bit-bots/bit_foot/electronics/README.md

The black board is the current version, the green version should not be used anymore and is only for documentation.

A fully functional BitFoot is composed of a black base board and a esp_connector board
