bit-bots/bit_foot/firmware/README

Use ADS Library available at https://github.com/Molorius/ADS126X
Use Dynamixel2Arduino library 
Use ESP32 board from Arduino board manager
