bit-bots/bit_foot/electronics/BOM_black.csv

ID | Name | Designator | Footprint | Quantity
1 | CONNEC_1X041.5 | P1,P2,P3,P4 | JST ZH 4PIN 1.5MM | 4
2 | TS2937CW-5.0 | U2 | SOT-223 | 1
3 | TS2940CW-3.3 | U3 | SOT-223 | 1
4 | 1K | R2,R1,R4,R3,R6,R5,R8,R7 | 0805 | 8
5 | 4K7 | R15,R11 | 0805 | 2
6 | ??? | R9 | 0805 | 1
7 | 22R | R19,R20 | 0805 | 2
8 | 47R | R10,R12,R13,R14,R16,R17,R18 | 0805 | 7
9 | DXL_TTL | P5 | MOLEX_SPOX_3 | 1
10 | 470nF | C22 | CASE-A_3216 | 1
11 | 1nF | C7,C6,C5,C10,C9,C8,C16,C15,C14,C19,C18,C17 | C0805 | 12
12 | 4.7nF | C11 | C0805 | 1
13 | 1uF | C13,C12,C1,C4 | C0805 | 4
14 | 0.1uF | C2,C3 | C0805 | 2
15 | 100nF | C24 | C0805 | 1
16 | 10uF | C21,C20 | CASE-B_3528 | 2
17 | SP485EEN-L/TR | U5 | SOIC-8_150MIL | 1
18 | 22uF | C23 | CASE-B_3528 | 1
19 | SMBJ9.0CA | D1,D2 | SMB(DO-214AA) | 2
20 | ADS1262 | U1 | TSSOP28 | 1
21 | DXL_RS485 | P6 | MOLEX SPOX | 1
22 | Header-Male-2.54_1x2 | H1 | HDR-2X1/2.54 | 1
