bit-bots/bit_foot/electronics/BOM_esp32_connector_board.csv

ID | Name | Designator | Footprint | Quantity | Manufacturer Part | Manufacturer
1 | SN74LV1T34DBVR | U2 | TSOT-23-5_L2.9-W1.6-P0.95-LS2.8-BL | 1 | SN74LV1T34DCKR | Texas Instruments
2 | ESP32-WROOM-32U | U1 | WIFIM-SMD_38P-L19.2-W18.0-P1.27 | 1 | ESP32-WROOM-32U | Espressif Systems
3 | 100nF | C2,C3 | C0805 | 2
4 | 10uF | C1 | C0805 | 1
6 | 4k7 | R1 | 0805 | 1
