bit-bots/bit_foot/electronics/schematic_black.pdf

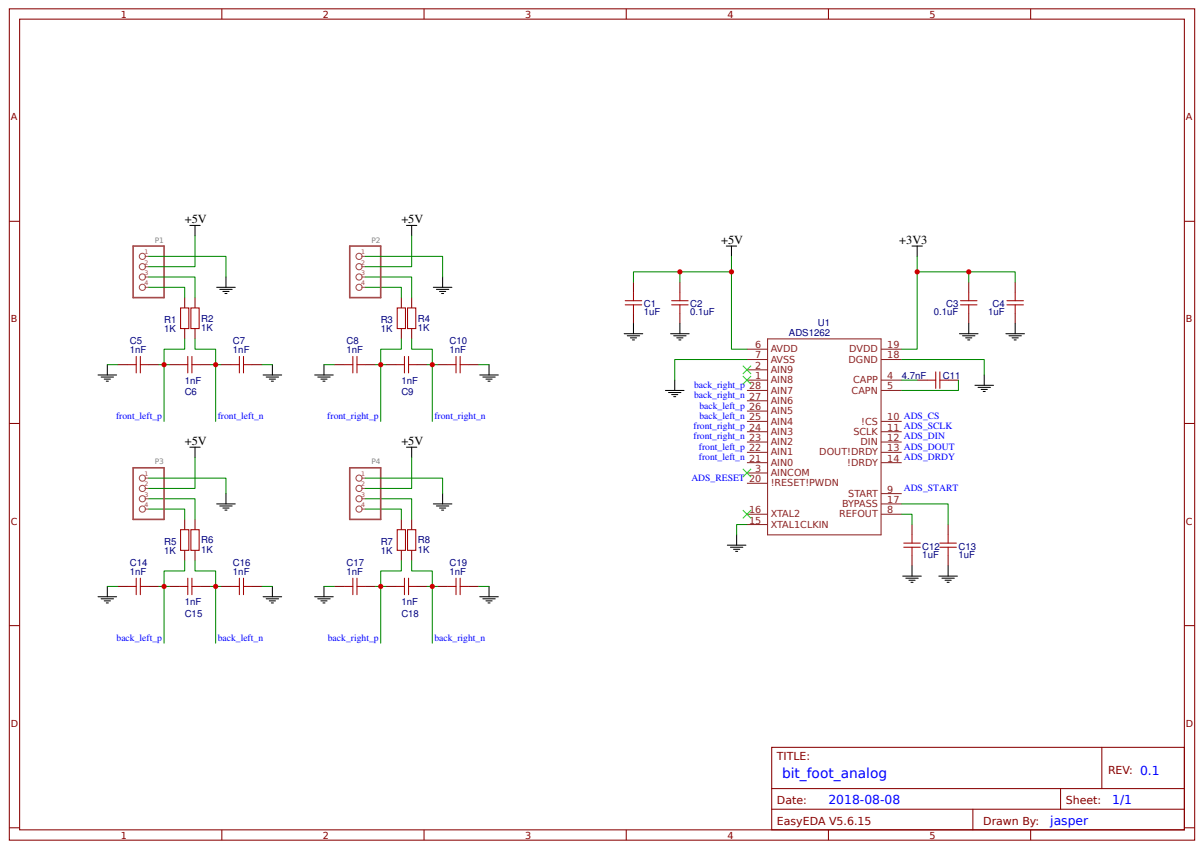
[picture p2: page 1]

V_DXL | 4
V_DXL | +5V

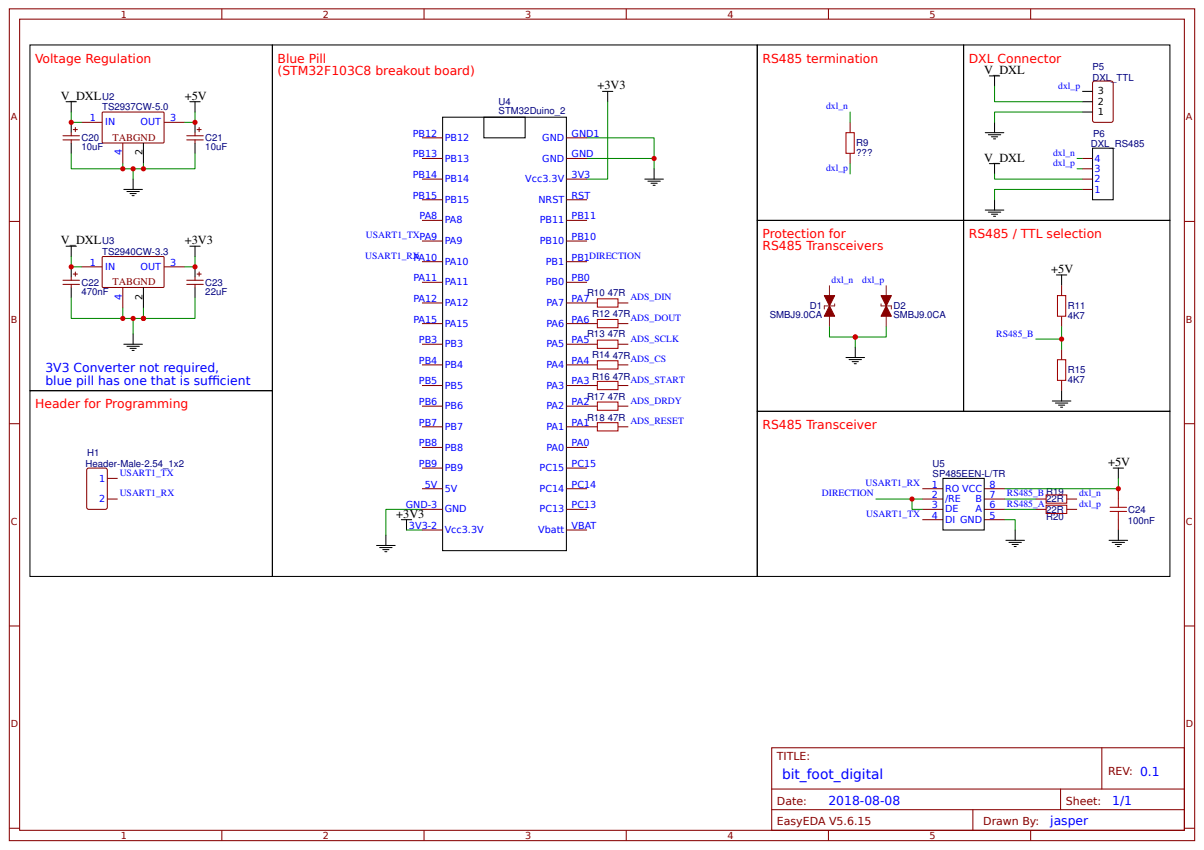
[picture p3: page 2]

3V3 Converter not required,
blue pill has one that is sufficient
Header for Programming
