bit-bots/bit_foot/electronics/schematic_green.pdf

V_DXL | 4
V_DXL | +5V

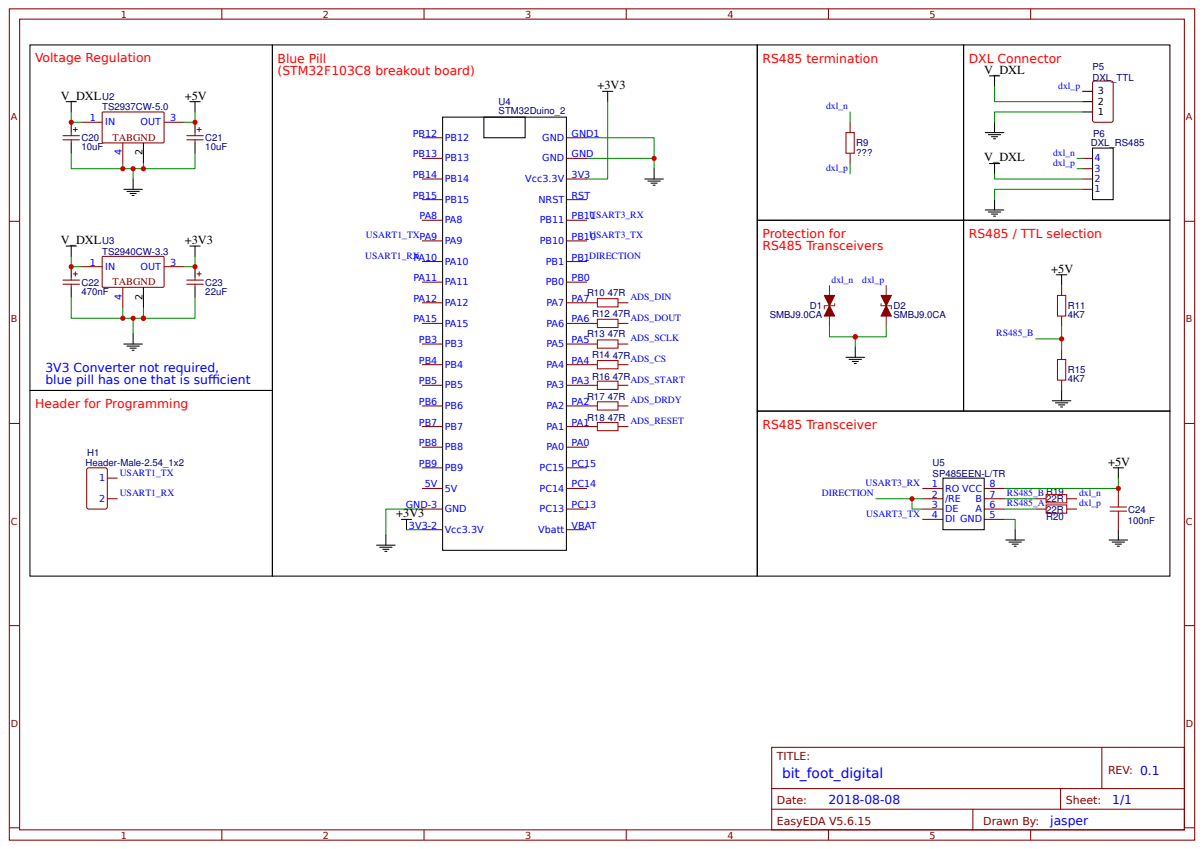
[picture p4: page 2]

3V3 Converter not required,
blue pill has one that is sufficient
Header for Programming
