bit-bots/bit_foot/electronics/board_esp_connector.pdf

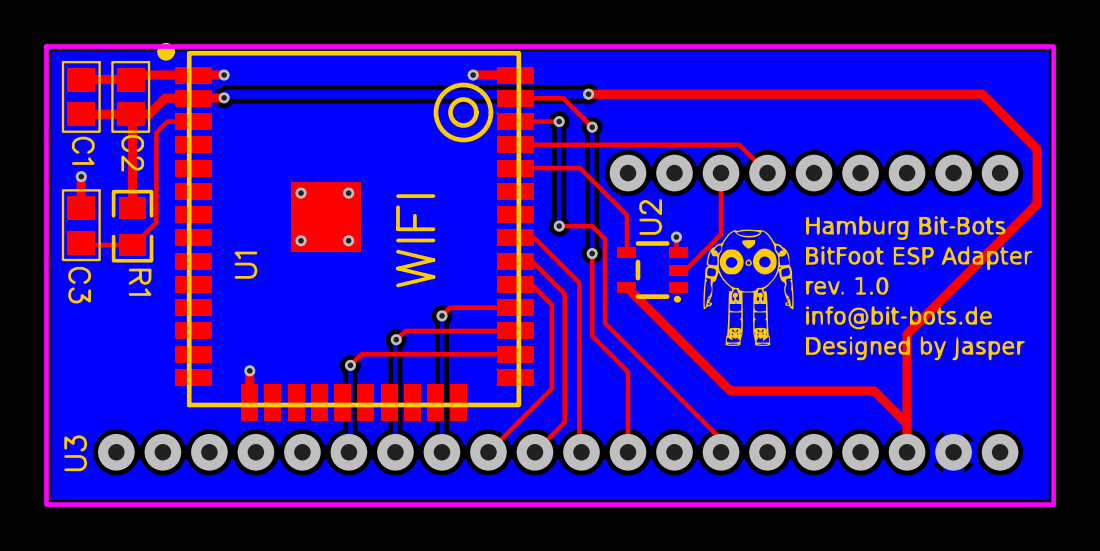
[picture p5: page 1]
