bit-bots/bit_foot/electronics/esp_connector.pdf

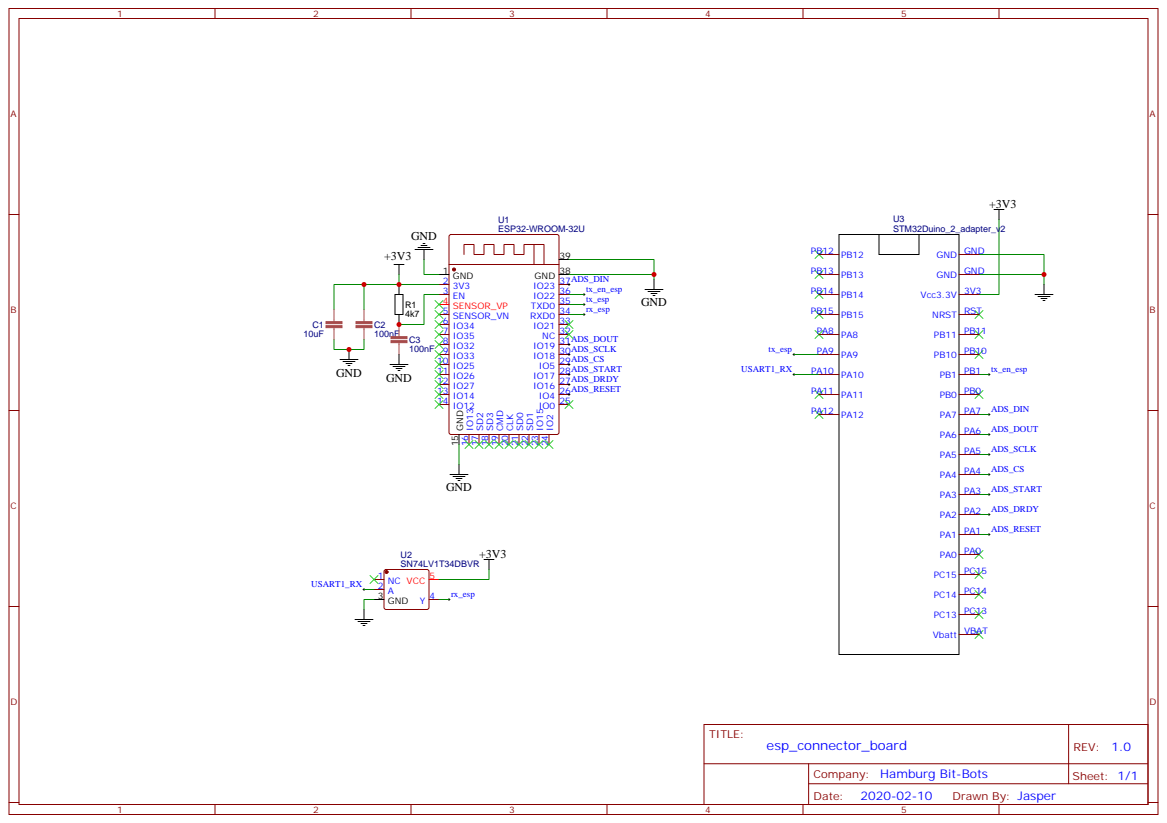
[picture p6: page 1]

Company: Hamburg Bit-Bots
