bit-bots/bit_foot/electronics/board_black.pdf

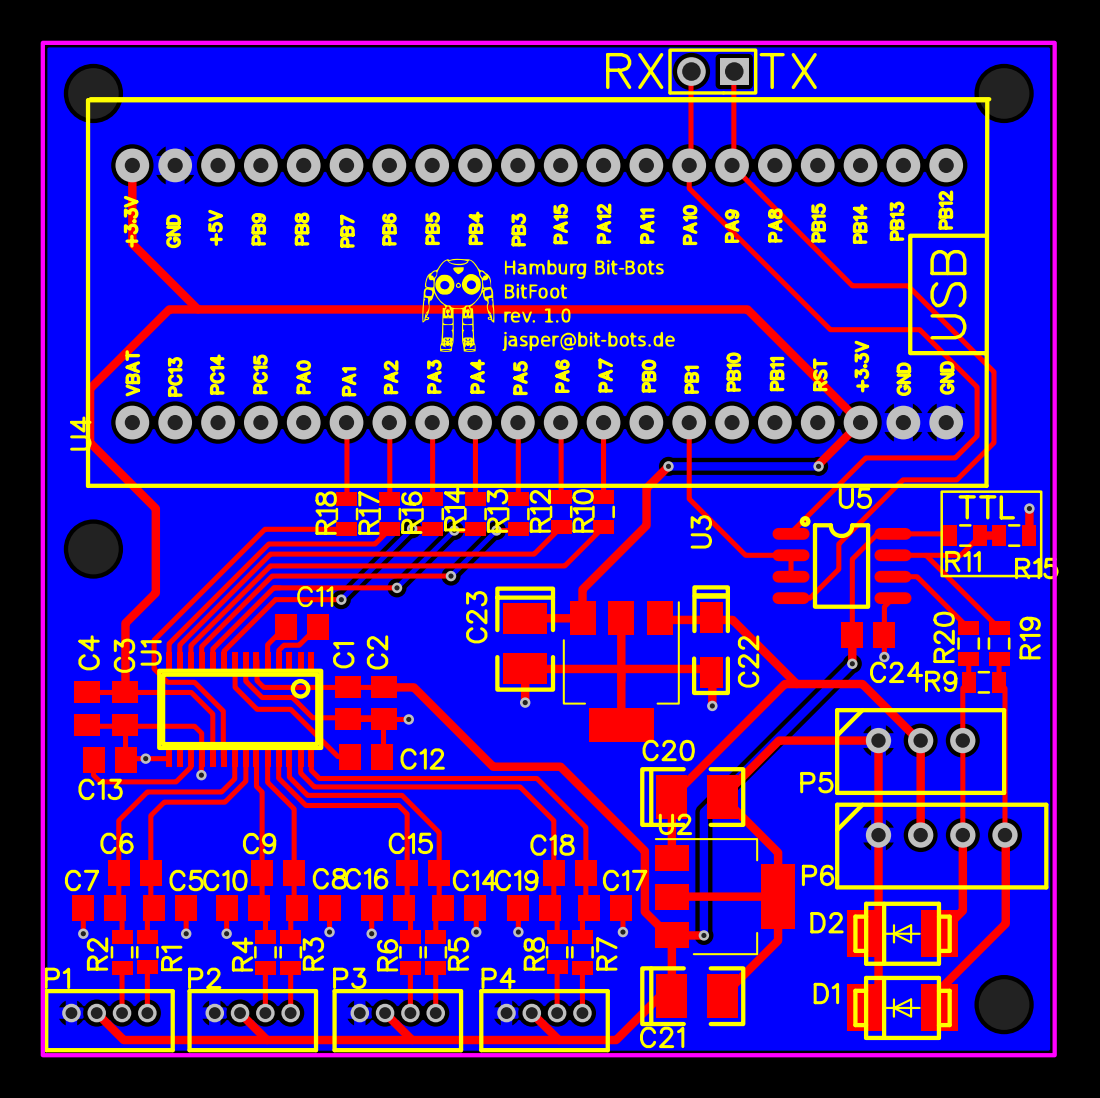
[picture p7: page 1]
