bit-bots/bit_foot/electronics/board_green.pdf

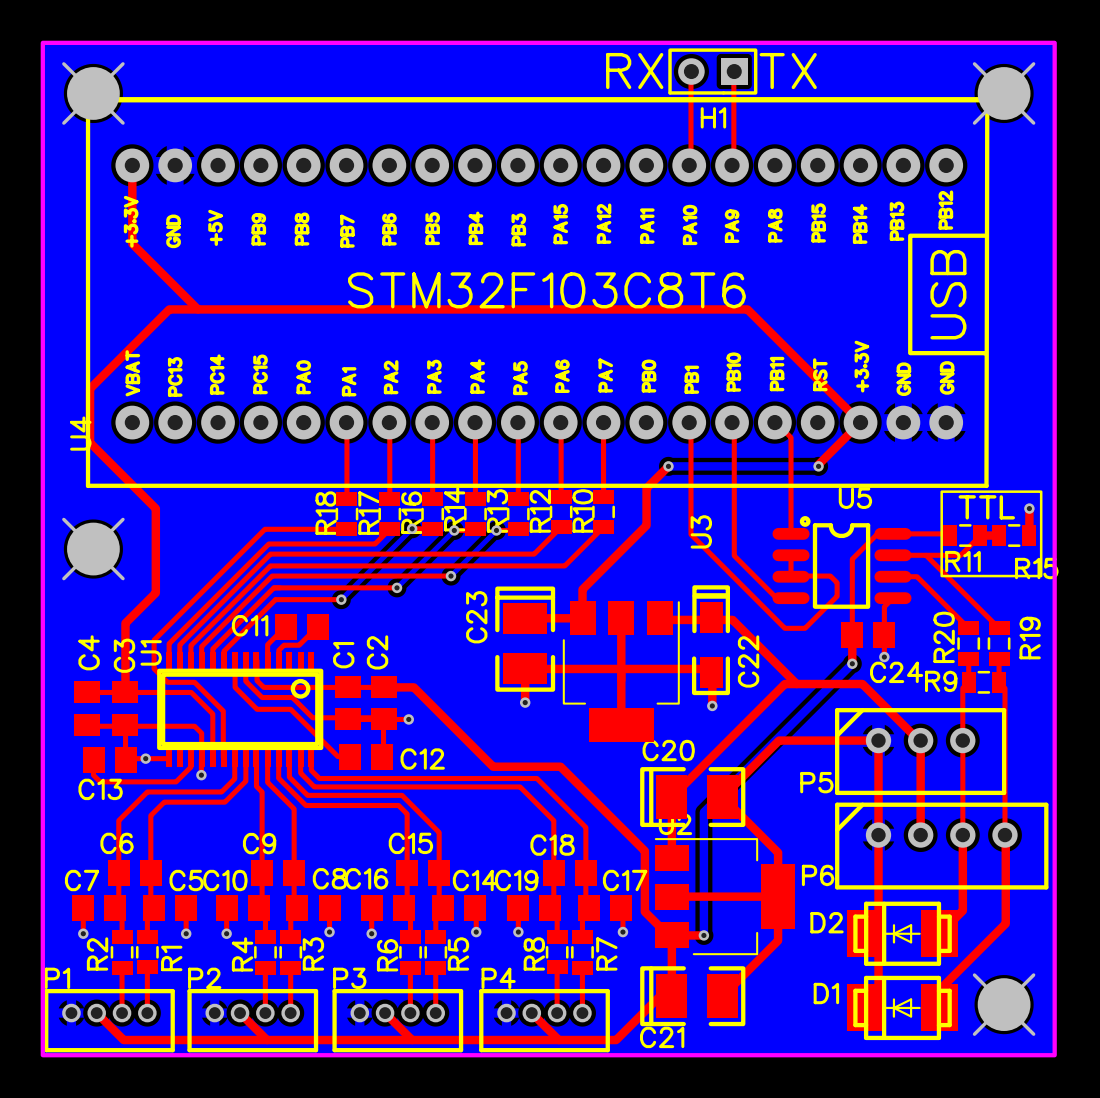
[picture p8: page 1]
