bit-bots/bit_foot/(threads)

Thread 1 (2019-11-21):

Use the DMA feature of the STM32F103 to stop reading errors

jgueldenstein, 2019-11-21:

Closed 2020-02-12.

Thread 4 (2021-11-08):

Improve reading of sensor

SammyRamone, 2021-11-08:
See solution here https://github.com/Molorius/ADS126X/issues/5#issuecomment-961457652
