bit-bots/bit_foot/firmware/esp32_bit_foot/fast_slave.h

/*******************************************************************************
* Copyright 2016 ROBOTIS CO., LTD.
*
* Licensed under the Apache License, Version 2.0 (the "License");
* you may not use this file except in compliance with the License.
* You may obtain a copy of the License at
*
*     http://www.apache.org/licenses/LICENSE-2.0
*
* Unless required by applicable law or agreed to in writing, software
* distributed under the License is distributed on an "AS IS" BASIS,
* WITHOUT WARRANTIES OR CONDITIONS OF ANY KIND, either express or implied.
* See the License for the specific language governing permissions and
* limitations under the License.
*******************************************************************************/

#ifndef DYNAMIXEL_FAST_SLAVE_HPP_
#define DYNAMIXEL_FAST_SLAVE_HPP_

#include <Dynamixel2Arduino.h>
#include "dxl_c/protocol.h"
#include "config.h"
#include "esp32-hal-uart.h"
#include "soc/uart_struct.h"

struct uart_struct_t {
  uart_dev_t * dev;
#if !CONFIG_DISABLE_HAL_LOCKS
  xSemaphoreHandle lock;
#endif
  uint8_t num;
  xQueueHandle queue;
  intr_handle_t intr_handle;
};


#define CONTROL_ITEM_MAX         64
#define CONTROL_ITEM_ADDR_LIMIT (DEFAULT_DXL_BUF_LENGTH-11)


namespace DYNAMIXEL{

class FastSlave
{
  public:
    FastSlave(DXLPortHandler &port, const uint16_t model_num, float protocol_ver = 2.0);
    FastSlave(const uint16_t model_num, float protocol_ver = 2.0);      

    bool setPacketBuffer(uint8_t* p_buf, uint16_t buf_capacity);
    uint8_t* getPacketBuffer() const;
    uint16_t getPacketBufferCapacity() const;

    uint16_t getModelNumber() const;
    
    bool setID(uint8_t id);
    uint8_t getID() const;

    void setFirmwareVersion(uint8_t version);
    uint8_t getFirmwareVersion() const;
    
    bool setPort(DXLPortHandler &port);
    bool setPort(DXLPortHandler *p_port);
    DXLPortHandler* getPort() const;
    
    bool setPortProtocolVersion(float version);
    bool setPortProtocolVersionUsingIndex(uint8_t version_idx);
    float getPortProtocolVersion() const;
    uint8_t getPortProtocolVersionIndex() const;

    void setWriteCallbackFunc(userCallbackFunc callback_func, void* callback_arg = nullptr);
    void setReadCallbackFunc(userCallbackFunc callback_func, void* callback_arg = nullptr);
    
    uint8_t getNumCanBeRegistered() const;
    bool isEnoughSpaceInControlTable(uint16_t start_addr, uint16_t length);

    uint8_t addControlItem(uint16_t start_addr, uint8_t* p_data, uint16_t length);
    uint8_t addControlItem(uint16_t start_addr, bool &data);
    uint8_t addControlItem(uint16_t start_addr, uint8_t &data);
    uint8_t addControlItem(uint16_t start_addr, uint16_t &data);
    uint8_t addControlItem(uint16_t start_addr, uint32_t &data);
    uint8_t addControlItem(uint16_t start_addr, uint64_t &data);
    uint8_t addControlItem(uint16_t start_addr, int8_t &data);
    uint8_t addControlItem(uint16_t start_addr, int16_t &data);
    uint8_t addControlItem(uint16_t start_addr, int32_t &data);
    uint8_t addControlItem(uint16_t start_addr, int64_t &data);
    uint8_t addControlItem(uint16_t start_addr, float &data);
    uint8_t addControlItem(uint16_t start_addr, double &data);

    bool processPacket(uart_t* uart);

    uint8_t getLastStatusPacketError() const;

    void setLastLibErrCode(DXLLibErrorCode_t err_code);
    DXLLibErrorCode_t getLastLibErrCode() const;

    // raw APIs
    bool txStatusPacket(uint8_t id, uint8_t err_code, uint8_t *p_param, uint16_t param_len);
    bool rxInstPacket(uint8_t* p_param_buf, uint16_t param_buf_cap);

  private:
    DXLPortHandler *p_port_;
    uart_t* uart_;
    
    const uint16_t model_num_;
    uint8_t protocol_ver_idx_;
    uint8_t firmware_ver_;
    uint8_t id_;

    bool is_buf_malloced_;
    uint8_t *p_packet_buf_;
    uint16_t packet_buf_capacity_;
    InfoToMakeDXLPacket_t info_tx_packet_;
    InfoToParseDXLPacket_t info_rx_packet_;

    DXLLibErrorCode_t last_lib_err_;

    uint8_t registered_item_cnt_;
    ControlItem_t control_table_[CONTROL_ITEM_MAX];

    userCallbackFunc user_write_callback_;
    void* user_write_callbakc_arg_;
    userCallbackFunc user_read_callback_;
    void* user_read_callbakc_arg_;

    virtual bool processInstPing();
    virtual bool processInstRead();
    virtual bool processInstWrite();
    
    bool processInst(uint8_t inst_idx);
    bool addDefaultControlItem();    
};

} // namespace DYNAMIXEL

#endif /* DYNAMIXEL_FAST_SLAVE_HPP_ */
