bit-bots/bit_foot/(commit log)

2019-05-22 changed filtering
2019-06-30 firmware for black version of foot sensor
2019-07-01 final firmware for the black version of the foot sensor
2019-07-07 boards gerber and schematic for rc2019
2020-03-21 esp32 firmware
2020-08-07 improving UART speed
2020-08-07 UART improvements
2021-01-14 hardware documentation
    [BOM_black.csv, BOM_esp32_connector_board.csv]
